tukicat/SDanShare/README.md

# SDanShare
A device for sharing the SD card between a Dandanator Multiply and Windows PC.

With this device the SD card for the Dandanator Multiply can remain in the Multiply and connected to the ZX Spectrum while powered on. At the same time it can be connected to a powered on PC. A press of the button will then let you switch between the two modes and a LED which tell you which mode you are in. 

This is useful if you want to curate game collections and delete or add games quickly without removing the SD card from the Multiply.

SDanShare Video (https://www.youtube.com/watch?v=ibojSRDSC9k)

*Demonstration Video*

**Bill of Materials**

The SDanShare is designed to be cheap and simple to make, the following components are required (all through hole): - [Bill of Materials](https://github.com/tukicat/SDanShare/blob/main/Bill%20of%20Materials.txt)

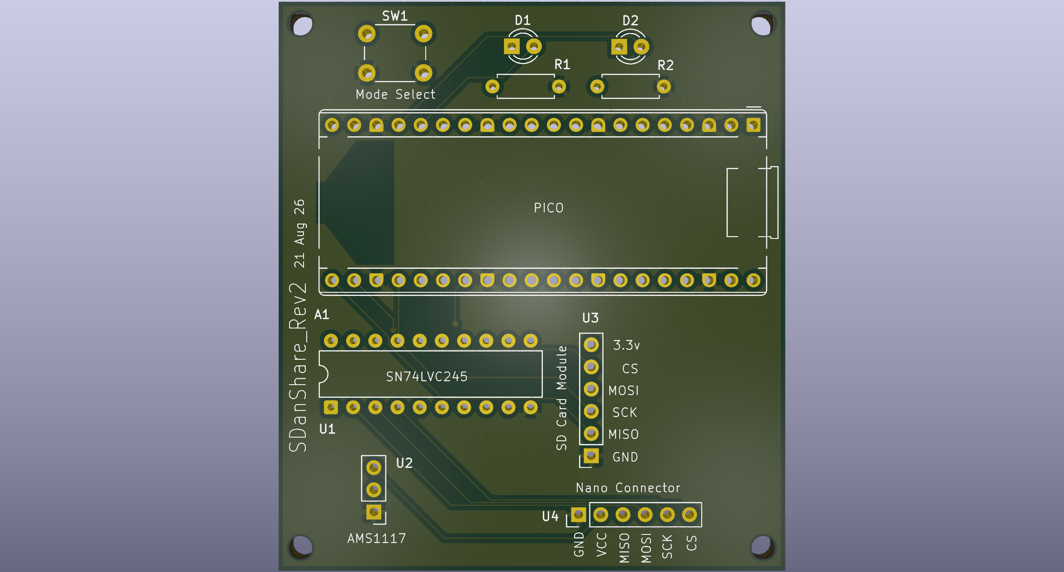
[picture p1: PCB/SDanShare_Rev2.png]
PCB Image


*PCB Layout*

**Scope and Disclaimer**

The ZX Spectrum along with the Dandanator reignited my passion for both the gaming and electronics. This small project was just my way of contributing something and learning at the same time. I have tested this as extensively as I can with the two ZX Spectrum +2s that I own - I have had no issues. That said I can offer no warranty on this device or guarantee on what issues may present themselves with other models of ZX Spectrum. 

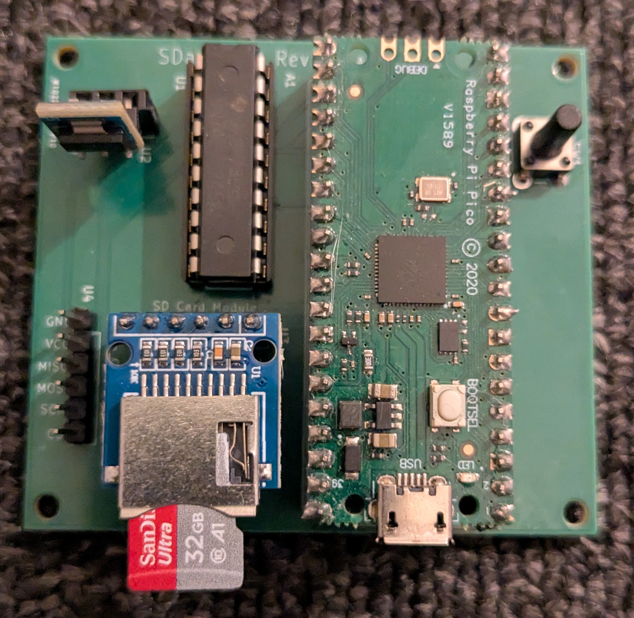
[picture p2: PCB/SDanShare Rev 1 Picture.jpg]
Rev 1 PCB Image


*Revision 1 Prototype*

**License**

The SDanShare is for free use you can redistribute it and/or modify it under the terms of the CC0 1.0 Universal License, or (at your option) any later version.

The SDanShare is distributed in the hope that it will be useful in some way, but WITHOUT ANY WARRANTY; without even the implied warranty of MERCHANTABILITY or FITNESS FOR A PARTICULAR PURPOSE. 

A copy of the full license can be found in the [LICENSE](https://github.com/tukicat/SDanShare/blob/main/LICENSE) file

**Acknowledgments**

My project is just a simple device that stands on the shoulders of the fantastic work by others, namely Dandare, Mad3001 and OverCLK. It is designed by me to compliment the two devices listed below which these three people worked as a team to create and develop:

The ZX Spectrum Dandantor - http://www.dandare.es/Proyectos_Dandare/ZX_Dandanator%21_Mini_EN.html

The Dandantor Multiply - https://github.com/mad3001/Multiply

**FAQ**

Q. This is a very niche thing, why make it?

A. Yes, it is very niche! There are three reasons for making it: -

1. It helped make the device easier for me to use.
2. I wanted to learn.
3. I'm frequently amazed at the number of people who develop devices like the Dandanator and Multiply and then give that work away to people for free, those people help to keep things like the ZX Spectrum alive. My very small contribution is me trying to also be one of those people. The Dandanator and Multiply are also two devices I personally think are great. They offer great functionality and are easy to make. 

Q. Do you intend to develop this device?

A. Yes, if I have time. 

Q. If I have an issue can you help?

A. If you post a comment in the issues section I'll try to address it, but I am learning as I go, so no promises!

Q. I can see all sorts of design flaws with this device - do you want to know about them?

A. Yes please, I am more than happy to hear from more experienced people who are willing to offer constructive feedback. Please leave comments in the issues section.
