tukicat/SDanShare/PCB/SDanShare_Rev2.pdf

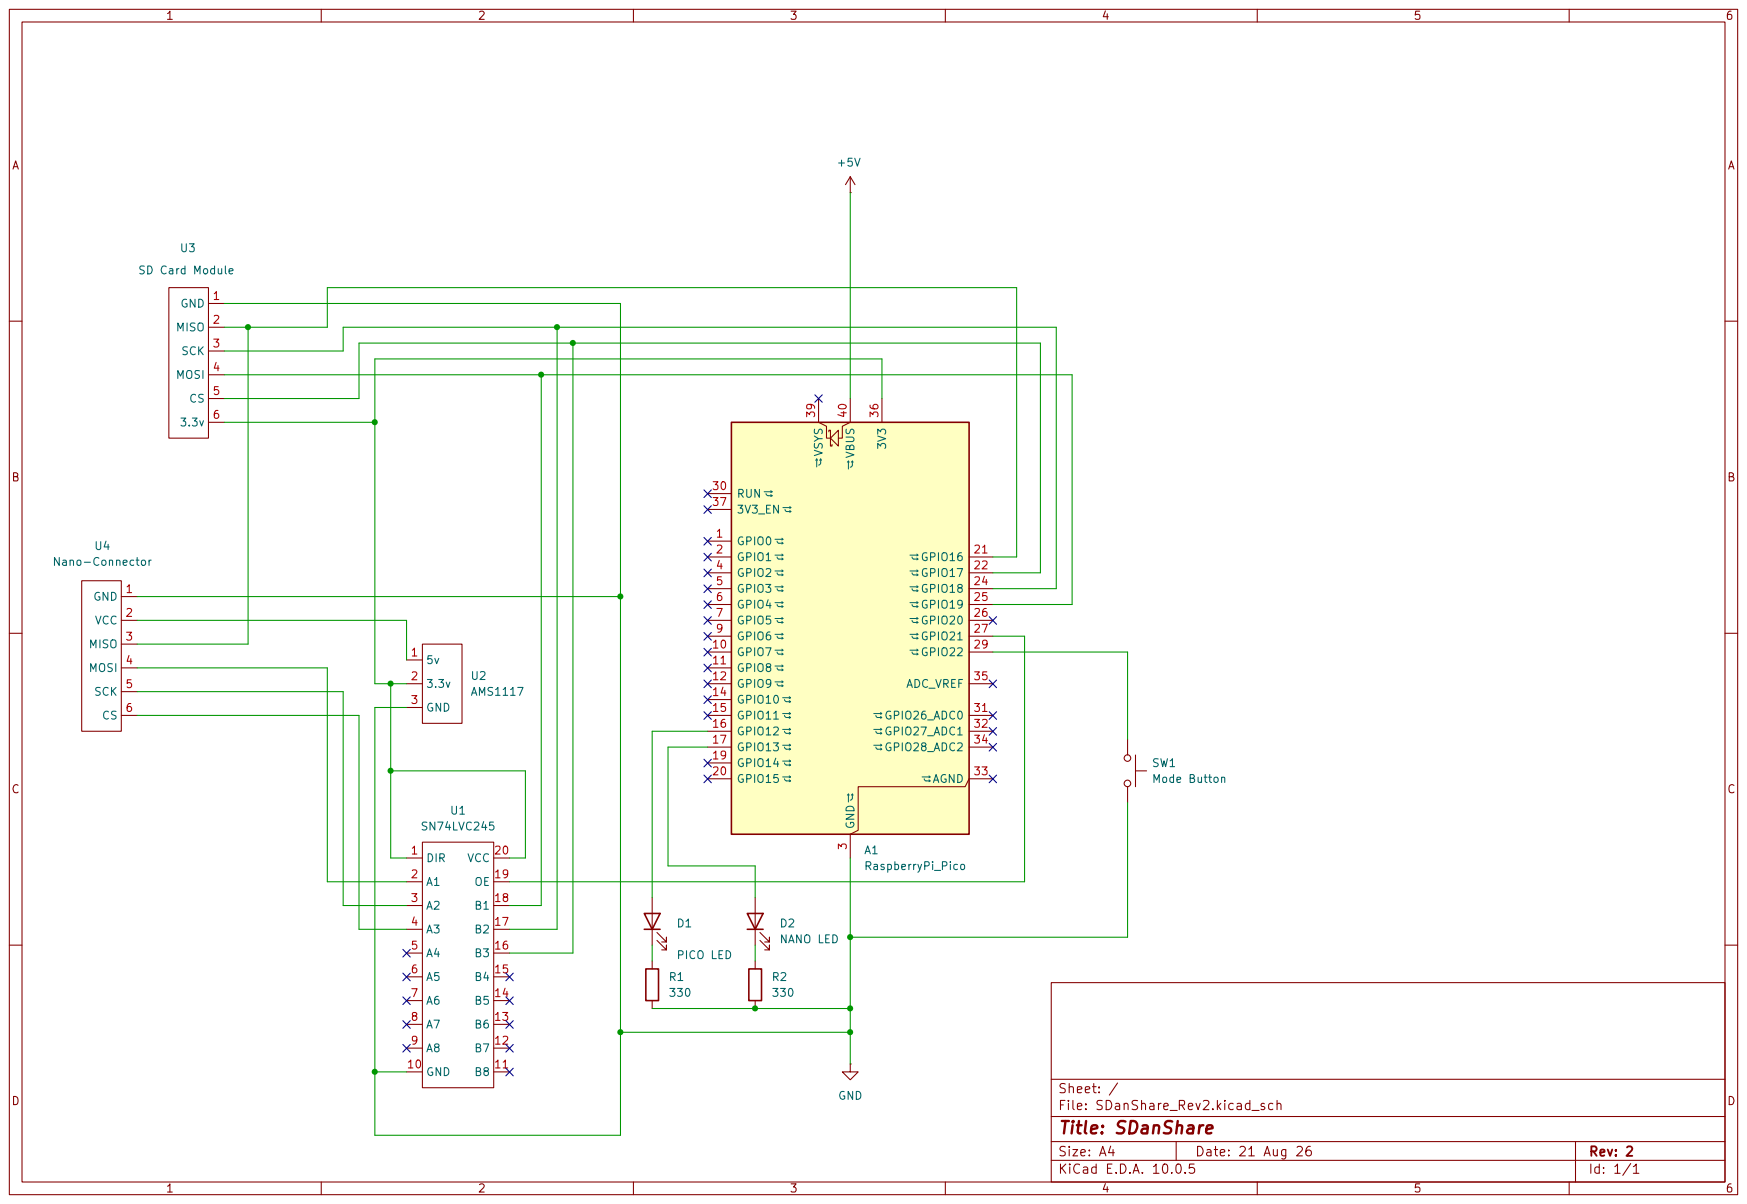
[picture p3: page 1]
