tukicat/SDanShare/(commit log)

2026-09-22 Add files via upload
    Gerber Files for PCB Manufacture (PCBWay)
2026-09-22 Add files via upload
    Schematic
2026-09-22 Add files via upload
    Raspberry Pi Pico Sketch with code for sharing of SD Card
2026-09-22 Add files via upload
    Replacement "Multiply_Arduino.ino" for Dandanator Multiply
    [Multiply_Arduino.ino]
2026-09-22 Add files via upload
    Gerber File for the SDanShare (PCBWay)
2026-09-22 Add files via upload
    SDanShare PCB Image
2026-09-22 Add files via upload
    Image of earlier SDanShare Rev 1 without LEDs
2026-09-22 Add files via upload
    Bill of Materials Required to make the SDanShare
2026-09-22 Update Bill of Materials.txt
2026-09-27 Add files via upload
    Pico Firmware for SDanShare
